Macikop/Solaris/electronics/3d views/mppt1.jpg

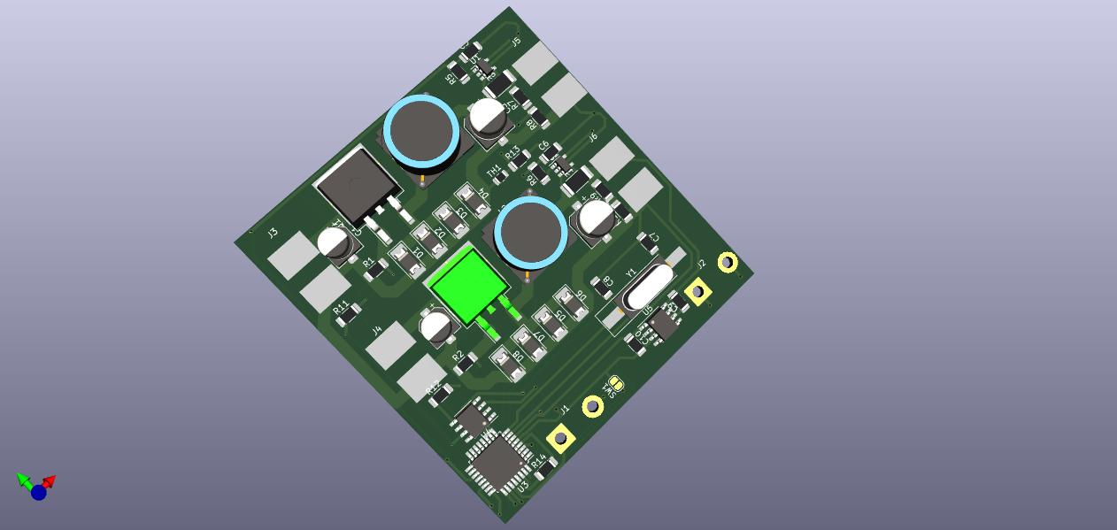
electronics/3d views/mppt1.jpg
