Macikop/Solaris/electronics/3d views/power_board.jpg

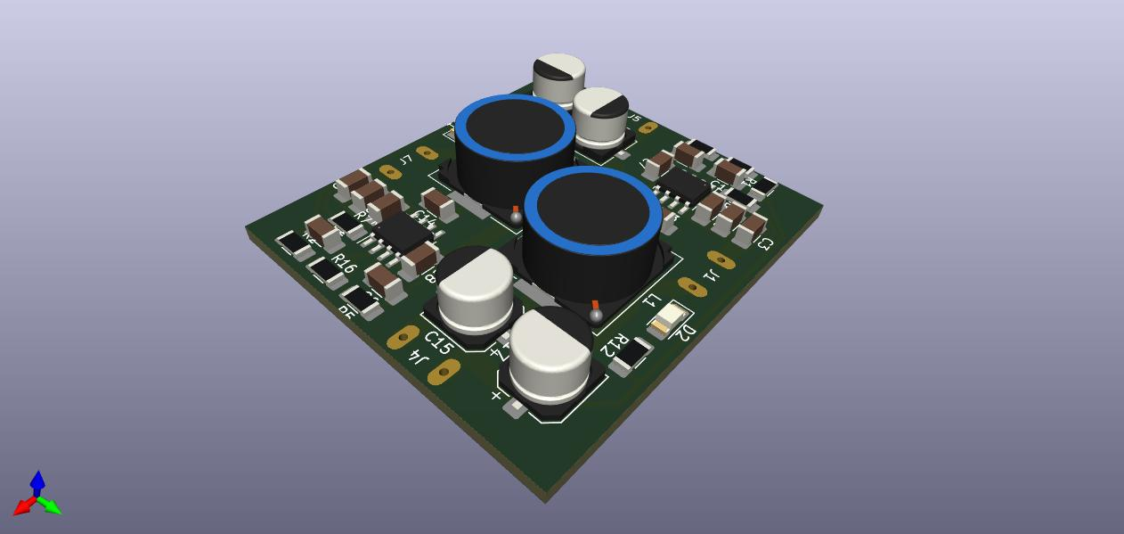
electronics/3d views/power_board.jpg
