Macikop/Solaris/electronics/3d views/autopilot.jpg

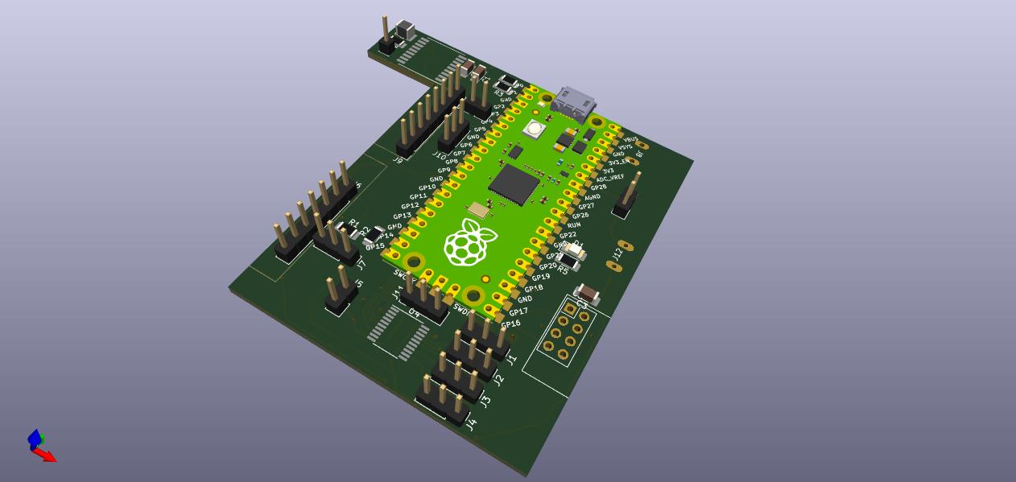
electronics/3d views/autopilot.jpg
