Macikop/Solaris/electronics/3d views/mppt.jpg

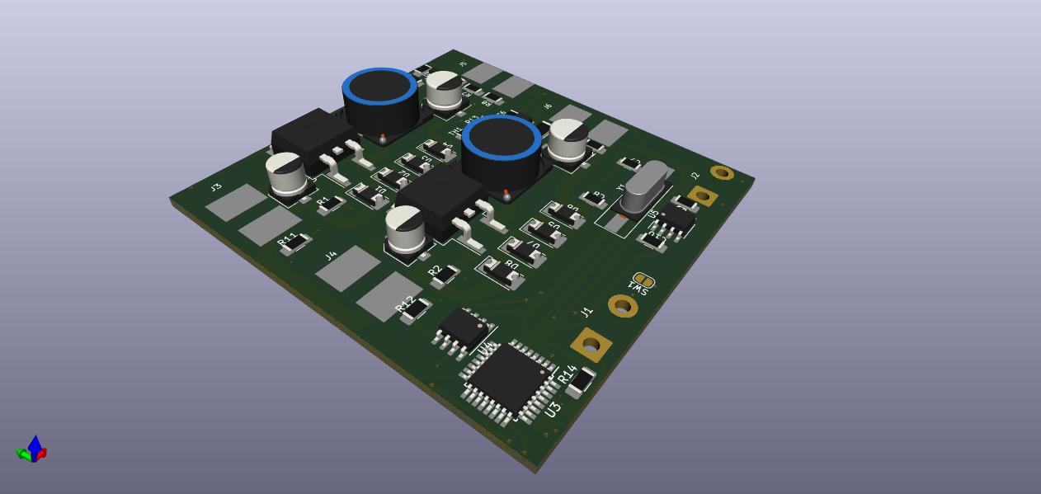
electronics/3d views/mppt.jpg
