Macikop/Solaris/electronics/3d views/power_board1.jpg

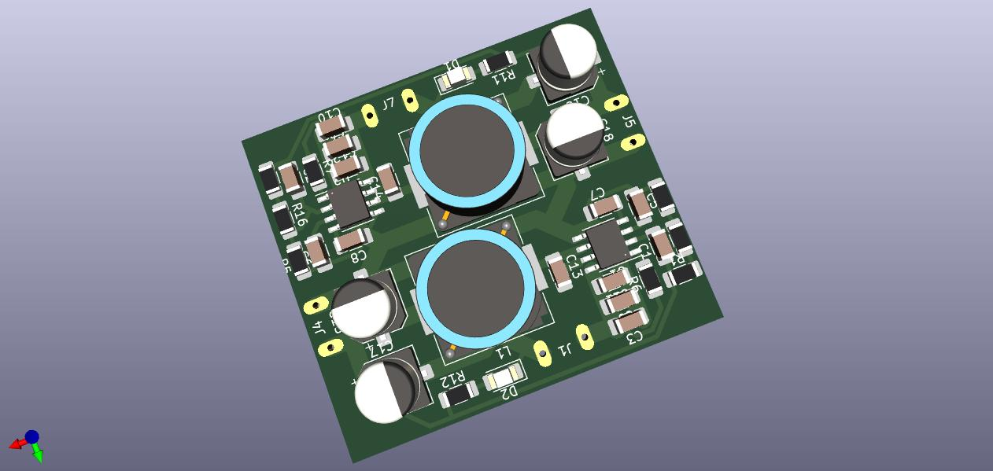
electronics/3d views/power_board1.jpg
