Macikop/Solaris/new model/Renders/Ino.png

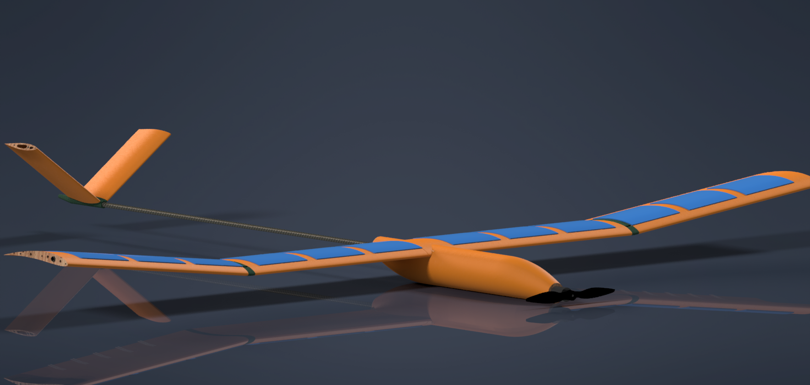
new model/Renders/Ino.png
