Macikop/Solaris/new model/Renders/Izo.png

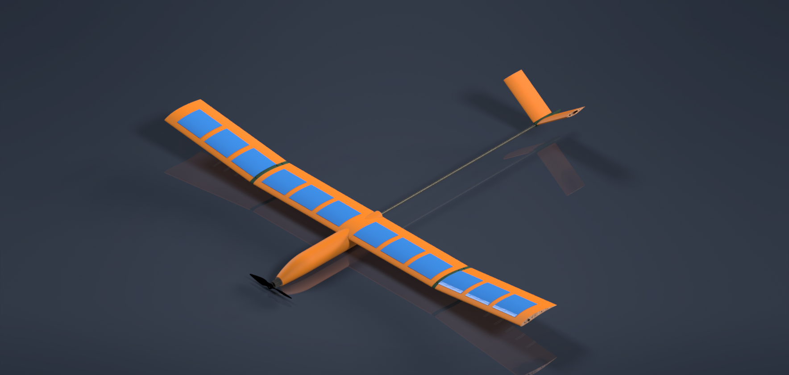
new model/Renders/Izo.png
