Macikop/Solaris/new model/Renders/Up.png

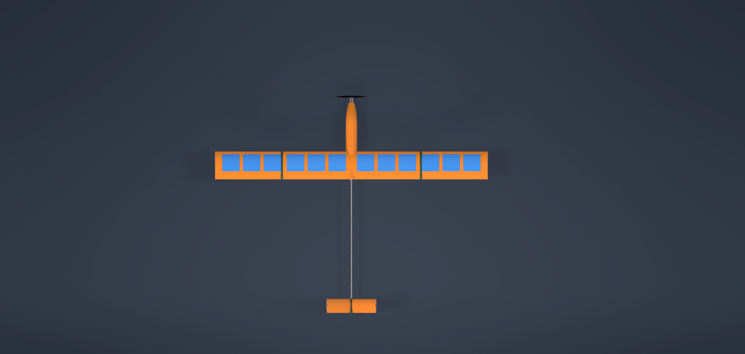
new model/Renders/Up.png
