Macikop/Solaris/new model/Renders/zic.png

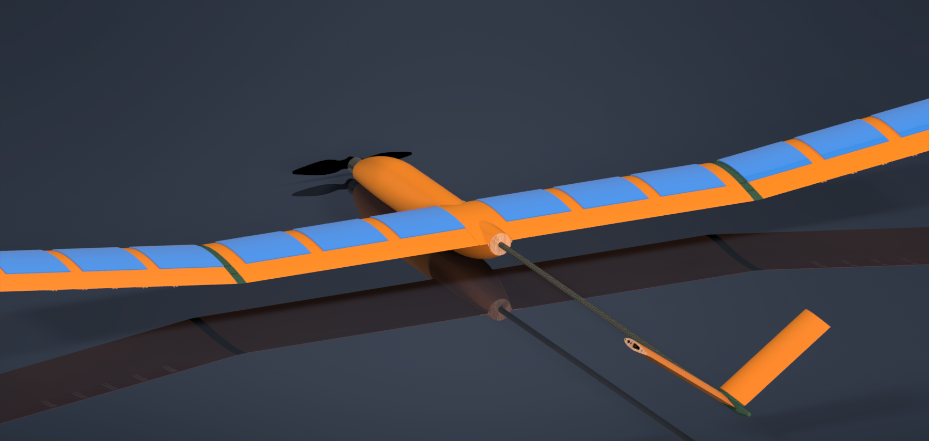
new model/Renders/zic.png
