Macikop/Solaris/new model/APC_9x6.SLDPRT

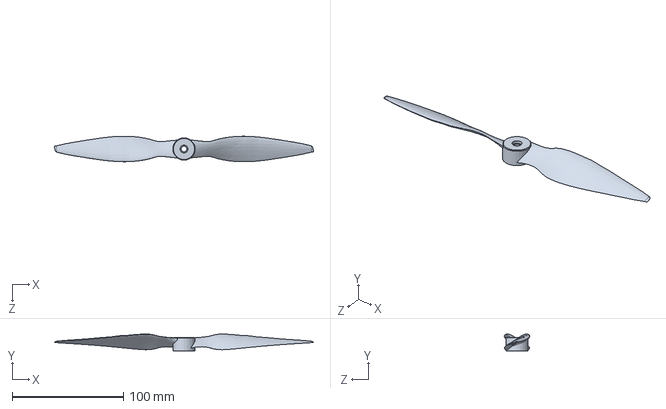
[picture p10: CAD file, 2023-02-10]
new model/APC_9x6.SLDPRT
232.6 x 15.2 x 22.9 mm
