Macikop/Solaris/(list of files, cad)

Other CAD files:
new model/Tail/Tżebro sketch.dwg
new model/APC_9x6.ipt
new model/Frez/Dlugie party(32-47)/OldVersions/Solid33.0001.ipt
new model/Frez/Dlugie party(32-47)/OldVersions/Solid35.0001.ipt
new model/Frez/Dlugie party(32-47)/OldVersions/Solid36.0001.ipt
new model/Frez/Dlugie party(32-47)/OldVersions/Solid37.0001.ipt
new model/Frez/Dlugie party(32-47)/OldVersions/Solid39.0001.ipt
new model/Frez/Dlugie party(32-47)/OldVersions/Solid40.0001.ipt
new model/Frez/Dlugie party(32-47)/OldVersions/Solid41.0001.ipt
new model/Frez/Dlugie party(32-47)/OldVersions/Solid42.0002.ipt
new model/Frez/Dlugie party(32-47)/OldVersions/Solid43.0002.ipt
new model/Frez/Dlugie party(32-47)/OldVersions/Solid44.0001.ipt
new model/Frez/Dlugie party(32-47)/OldVersions/Solid45.0001.ipt
new model/Frez/Dlugie party(32-47)/OldVersions/Solid46.0002.ipt
new model/Frez/Dlugie party(32-47)/OldVersions/Solid47.0002.ipt
new model/Frez/Dlugie party(32-47)/Solid32.ipt
new model/Frez/Dlugie party(32-47)/Solid33.ipt
new model/Frez/Dlugie party(32-47)/Solid34.ipt
new model/Frez/Dlugie party(32-47)/Solid35.ipt
new model/Frez/Dlugie party(32-47)/Solid36.ipt
new model/Frez/Dlugie party(32-47)/Solid37.ipt
new model/Frez/Dlugie party(32-47)/Solid38.ipt
new model/Frez/Dlugie party(32-47)/Solid39.ipt
new model/Frez/Dlugie party(32-47)/Solid40.ipt
new model/Frez/Dlugie party(32-47)/Solid41.ipt
new model/Frez/Dlugie party(32-47)/Solid42.ipt
new model/Frez/Dlugie party(32-47)/Solid43.ipt
new model/Frez/Dlugie party(32-47)/Solid44.ipt
new model/Frez/Dlugie party(32-47)/Solid45.ipt
new model/Frez/Dlugie party(32-47)/Solid46.ipt
new model/Frez/Dlugie party(32-47)/Solid47.ipt
new model/Frez/Frezowanie No.1.iam
new model/Frez/Frezowanie No.2.iam
new model/Frez/Frezowanie_male No.1.iam
new model/Frez/Frezowanie_male No.2.iam
new model/Frez/Frezowanie_male No.3.iam
new model/Frez/Kuplungi(48-65)/Solid48.ipt
new model/Frez/Kuplungi(48-65)/Solid49.ipt
new model/Frez/Kuplungi(48-65)/Solid50.ipt
new model/Frez/Kuplungi(48-65)/Solid51.ipt
new model/Frez/Kuplungi(48-65)/Solid52.ipt
new model/Frez/Kuplungi(48-65)/Solid53.ipt
new model/Frez/Kuplungi(48-65)/Solid54.ipt
new model/Frez/Kuplungi(48-65)/Solid55.ipt
new model/Frez/Kuplungi(48-65)/Solid56.ipt
new model/Frez/Kuplungi(48-65)/Solid57.ipt
new model/Frez/Kuplungi(48-65)/Solid60.ipt
new model/Frez/Kuplungi(48-65)/Solid61.ipt
new model/Frez/Kuplungi(48-65)/Solid62.ipt
new model/Frez/Kuplungi(48-65)/Solid63.ipt
new model/Frez/Kuplungi(48-65)/Solid64.ipt
new model/Frez/Kuplungi(48-65)/Solid65.ipt
new model/Frez/Laminat235x235.ipt
new model/Frez/Laminat297x210.ipt
new model/Frez/OldVersions/Frezowanie No.1.0007.iam
new model/Frez/OldVersions/Frezowanie No.2.0005.iam
new model/Frez/OldVersions/Frezowanie_male No.1.0004.iam
new model/Frez/OldVersions/Frezowanie_male No.2.0003.iam
new model/Frez/OldVersions/Frezowanie_male No.3.0003.iam
new model/Frez/Troche Mniejsze(2-31)/OldVersions/Solid2.0001.ipt
new model/Frez/Troche Mniejsze(2-31)/OldVersions/Solid28.0002.ipt
new model/Frez/Troche Mniejsze(2-31)/OldVersions/Solid29.0002.ipt
new model/Frez/Troche Mniejsze(2-31)/OldVersions/Solid30.0002.ipt
new model/Frez/Troche Mniejsze(2-31)/OldVersions/Solid31.0002.ipt
new model/Frez/Troche Mniejsze(2-31)/Solid10.ipt
new model/Frez/Troche Mniejsze(2-31)/Solid11.ipt
new model/Frez/Troche Mniejsze(2-31)/Solid12.ipt
new model/Frez/Troche Mniejsze(2-31)/Solid13.ipt
new model/Frez/Troche Mniejsze(2-31)/Solid14.ipt
new model/Frez/Troche Mniejsze(2-31)/Solid15.ipt
new model/Frez/Troche Mniejsze(2-31)/Solid16.ipt
new model/Frez/Troche Mniejsze(2-31)/Solid17.ipt
new model/Frez/Troche Mniejsze(2-31)/Solid18.ipt
new model/Frez/Troche Mniejsze(2-31)/Solid2.ipt
new model/Frez/Troche Mniejsze(2-31)/Solid28.ipt
new model/Frez/Troche Mniejsze(2-31)/Solid29.ipt
new model/Frez/Troche Mniejsze(2-31)/Solid3.ipt
new model/Frez/Troche Mniejsze(2-31)/Solid30.ipt
new model/Frez/Troche Mniejsze(2-31)/Solid31.ipt
new model/Frez/Troche Mniejsze(2-31)/Solid4.ipt
new model/Frez/Troche Mniejsze(2-31)/Solid5.ipt
new model/Frez/Troche Mniejsze(2-31)/Solid6.ipt
new model/Frez/Troche Mniejsze(2-31)/Solid7.ipt
new model/Frez/Troche Mniejsze(2-31)/Solid8.ipt
new model/Frez/Troche Mniejsze(2-31)/Solid9.ipt
new model/Frez_zebra/Balsa(95x1000x3).ipt
new model/Frez_zebra/Frez No,1.iam
new model/Frez_zebra/Frez No,2.iam
new model/Frez_zebra/Frez No,3.iam
new model/Frez_zebra/OldVersions/Balsa(95x1000x1.5).0003.ipt
new model/Frez_zebra/OldVersions/Frez No,1.0003.iam
new model/Frez_zebra/OldVersions/Frez No,2.0001.iam
new model/Jig/Back_back_aligner.ipt
new model/Jig/Back_front_aligner.ipt
new model/Jig/Front_aligner.ipt
new model/Jig/Jig_1.ipt
new model/Jig/Jig_2.ipt
new model/Jig/Jig_assembly.iam
new model/Jig/OldVersions/Back_front_aligner.0001.ipt
new model/Jig/OldVersions/Front_aligner.0003.ipt
new model/Jig/OldVersions/Jig_1.0010.ipt
new model/Jig/OldVersions/Jig_2.0006.ipt
new model/Jig/OldVersions/Jig_assembly.0012.iam
new model/Jig/Slider.ipt
new model/Jig/Widełki.ipt
new model/Lotka.ipt
new model/OldVersions/Lotka.0004.ipt
new model/OldVersions/Panele.0004.ipt
new model/OldVersions/Part17.0001.ipt
new model/OldVersions/Part19.0001.ipt
new model/OldVersions/Poszycie skrzydlo glowne.0001.ipt
new model/OldVersions/Poszycie skrzydlo sterowe.0003.ipt
new model/OldVersions/Poszycie.0005.ipt
new model/OldVersions/Powietrze.0001.ipt
new model/OldVersions/Samolot.0037.iam
new model/OldVersions/Skrzydło.0023.iam
new model/OldVersions/Tmount.0001.ipt
new model/OldVersions/Tżebro sketch.0001.ipt
new model/OldVersions/Wingspar trochemniejnizpol metrowy.0002.ipt
new model/OldVersions/battery.0001.ipt
new model/OldVersions/cienki_spar_dlugi.0003.ipt
new model/OldVersions/cienki_spar_krotki__ale_troche_dluzszy.0001.ipt
new model/OldVersions/kadlub_assembly.0003.iam
new model/OldVersions/kadłub.0011.ipt
new model/OldVersions/kuplung.0006.ipt
new model/OldVersions/mew.0001.iam
new model/OldVersions/skrzydlo_ster.0006.iam
new model/OldVersions/wingspar.0002.ipt
new model/OldVersions/Żebro default.0002.ipt
new model/OldVersions/Żebro sketch.0001.ipt
new model/OldVersions/Żebro z lotką.0002.ipt
new model/OldVersions/Żerbo montaż.0002.ipt
new model/Panele.ipt
new model/Poszycie skrzydlo glowne.ipt
new model/Poszycie skrzydlo sterowe.ipt
new model/Poszycie.ipt
new model/Prezentacje/OldVersions/Samolot.0001.ipn
new model/Prezentacje/Samolot.ipn
new model/Samolot bez sparow.iam
new model/Samolot.iam
new model/Silnik.ipt
new model/Skrzydlo_ster_mir/Lotka_MIR.ipt
new model/Skrzydlo_ster_mir/Wingspar trochemniejnizpol metrowy_MIR.ipt
new model/Skrzydlo_ster_mir/Zebro_lotka_MIR.iam
new model/Skrzydlo_ster_mir/skrzydlo_ster_MIR.iam
new model/Skrzydlo_ster_mir/Żebro default_MIR.ipt
new model/Skrzydlo_ster_mir/Żebro z lotką_MIR.ipt
new model/Skrzydlo_ster_mir/Żerbo montaż_MIR.ipt
new model/Skrzydło.iam
new model/Tail/OldVersions/Tail Poszycie.0002.ipt
new model/Tail/OldVersions/Tail.0010.iam
new model/Tail/OldVersions/Tmouint-edito.0007.ipt
new model/Tail/OldVersions/Tmount.0004.ipt
new model/Tail/OldVersions/TsmallSpar.0001.ipt
new model/Tail/OldVersions/Twingspar.0001.ipt
new model/Tail/Tail Poszycie.ipt
new model/Tail/Tail.iam
new model/Tail/Tlotka.ipt
new model/Tail/Tmouint-edito.ipt
new model/Tail/Tmount.ipt
new model/Tail/TsmallSpar.ipt
new model/Tail/Twingspar.ipt
new model/Tail/Tżebro default.ipt
new model/Tail/Tżebro sketch.ipt
new model/Tail/Tżebro z lotkąt.ipt
new model/Tail/Zebro_z_lotka.iam
new model/Wingspar trochemniejnizpol metrowy.ipt
new model/Zebro_lotka.iam
new model/battery.ipt
new model/cienki_spar_dlugi.ipt
new model/cienki_spar_krotki__ale_troche_dluzszy.ipt
new model/devices/ESC.ipt
new model/devices/OldVersions/Radio.0003.ipt
new model/devices/Radio.ipt
new model/kadłub.ipt
new model/kuplung.ipt
new model/motor.ipt
new model/nowy kadłub.ipt
new model/skrzydlo_ster.iam
new model/wingspar.ipt
new model/Żebro default.ipt
new model/Żebro sketch.ipt
new model/Żebro z lotką.ipt
new model/Żerbo montaż.ipt
