Macikop/Solaris/electronics/autopilot/autopilot.pdf

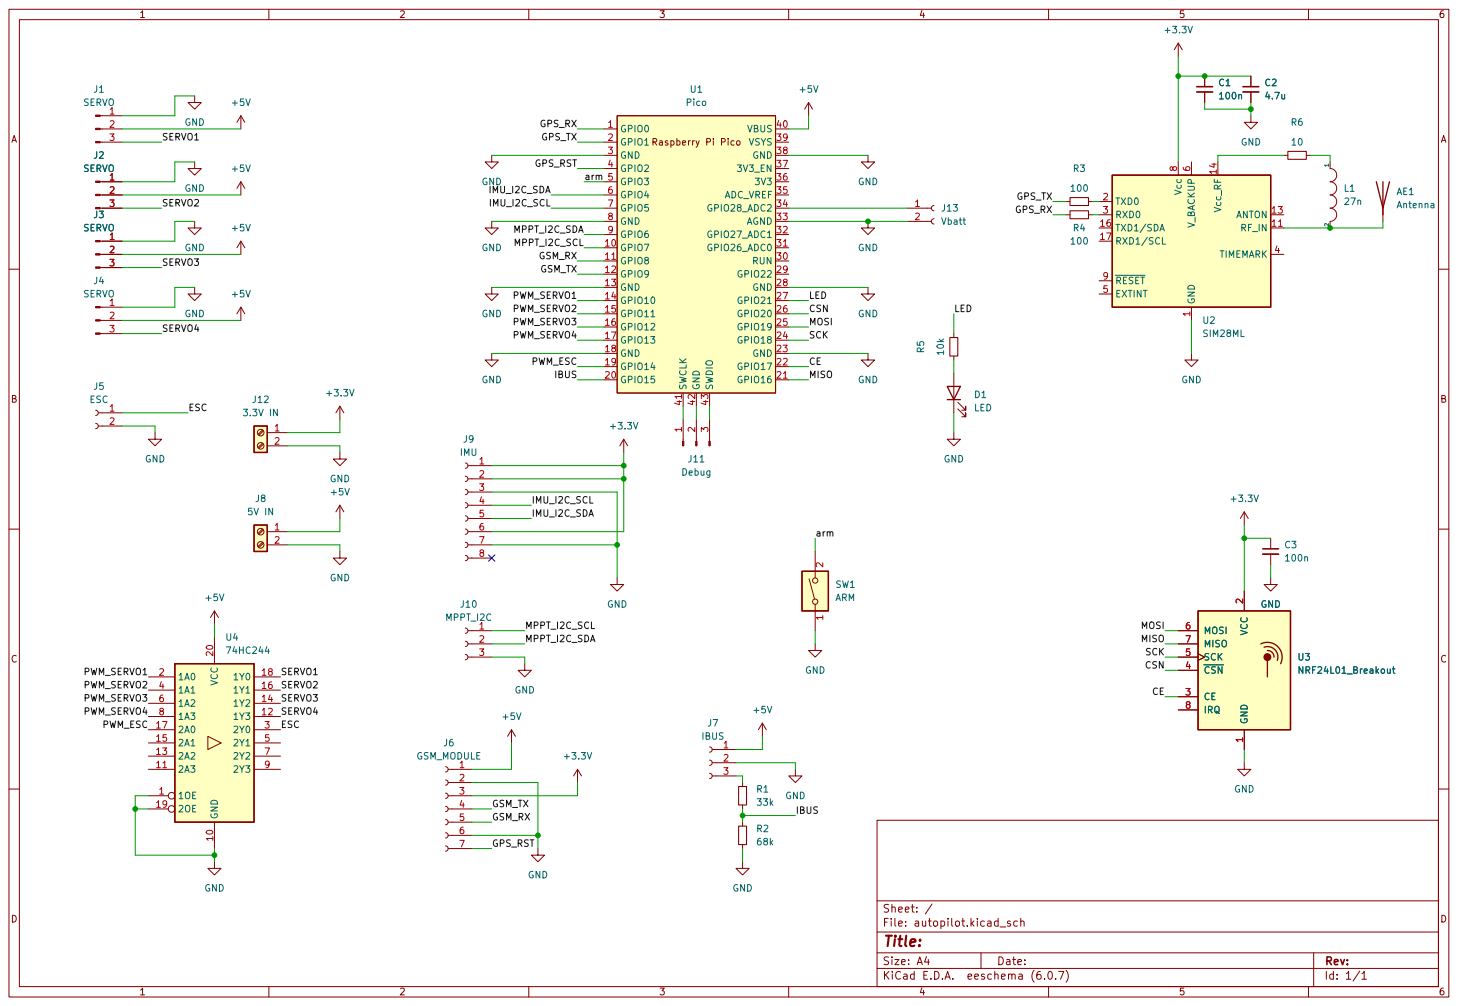
[picture p11: page 1]

GPS_RST GSM_RX GSM_TX GPS_RX GPS_TX
IMU GND GND GND GND

1 RF_IN 11 ANTON Vcc_RF 13 14 TXD1/SDA 16 RXD1/SCL 17 TXD0 2 RXD0 3 TIMEMARK 4 EXTINT 5 V_BACKUP

2 CE 3 ~{CSN} 4 SCK 5 MOSI 6 MISO 7
