Macikop/Solaris/new electronics/mppt/mppt/mppt.kicad_pcb

## KiCad design new electronics/mppt/mppt/mppt.kicad_pcb (2023-10-06)

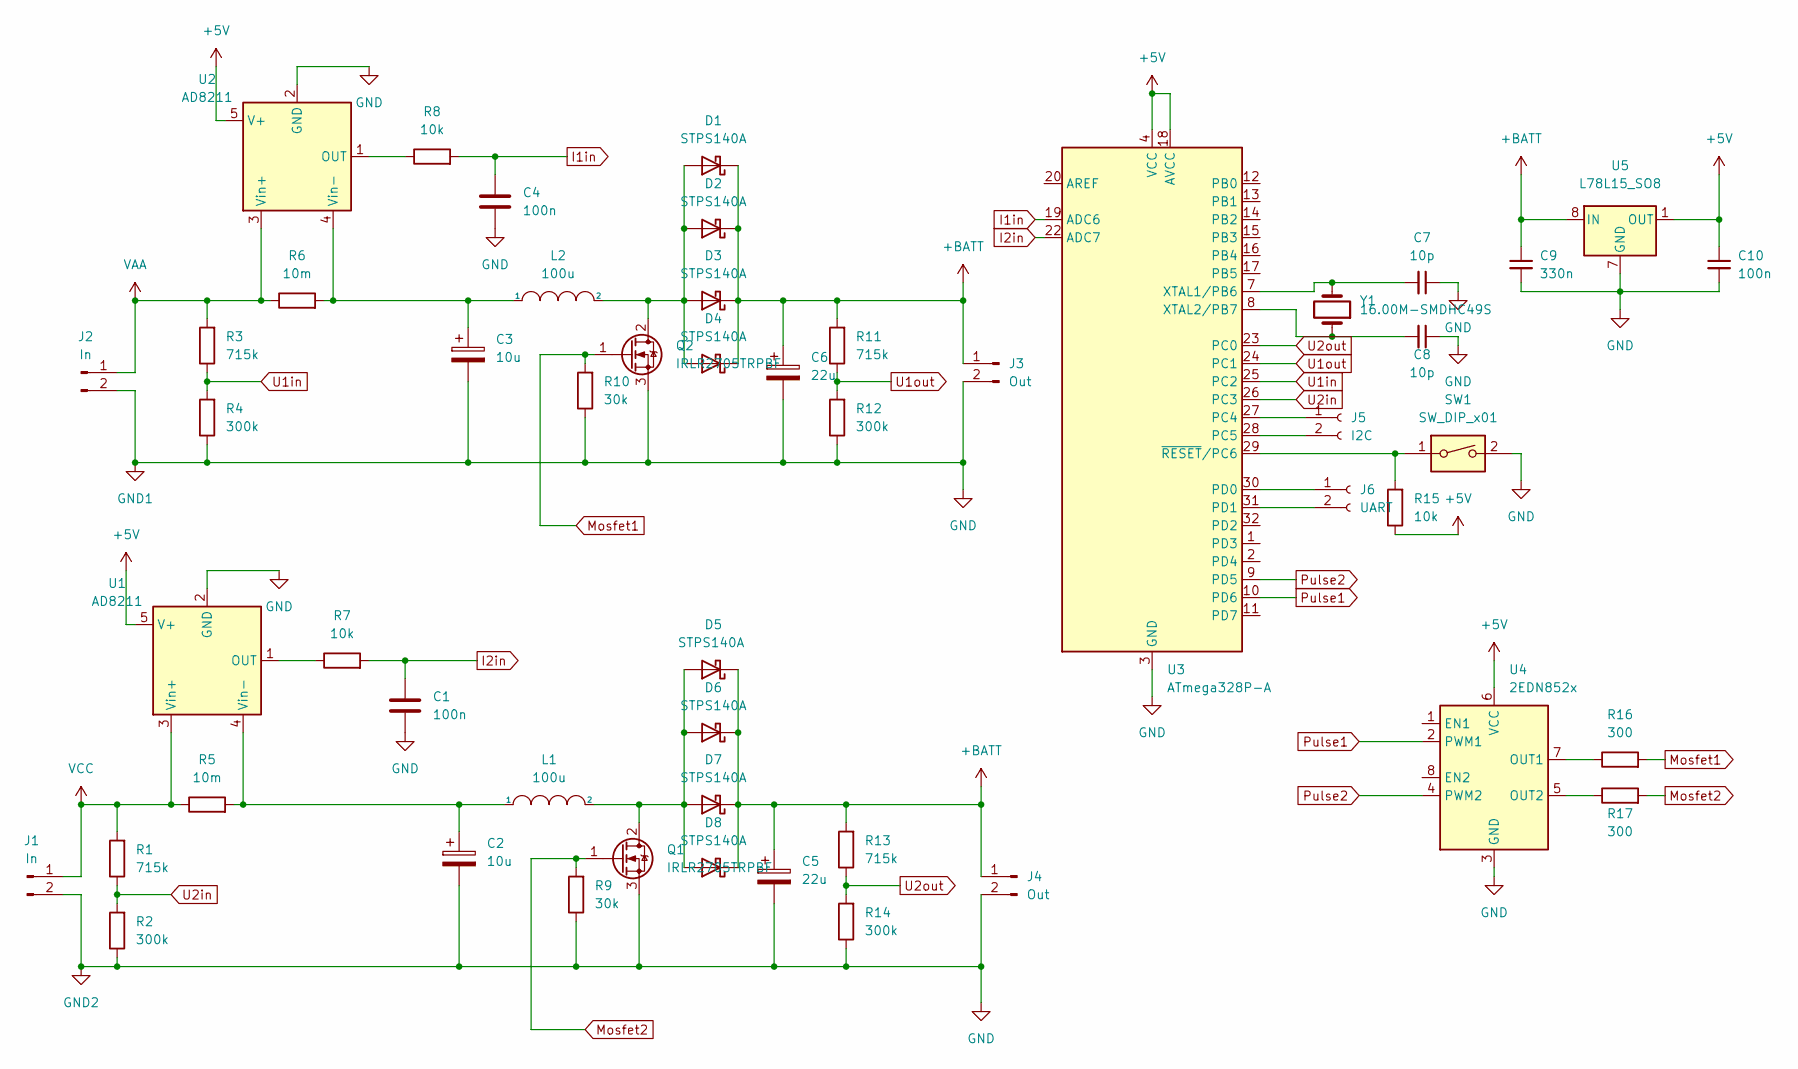
[picture p12: schematic mppt.kicad_sch]

Parts:
C1, C4, C10: 100n; R_1206_3216Metric_Pad1.30x1.75mm_HandSolder
C2, C3: 10u; CP_EIA-7343-15_Kemet-W_Pad2.25x2.55mm_HandSolder
C5, C6: 22u; CP_EIA-7343-15_Kemet-W_Pad2.25x2.55mm_HandSolder
C7, C8: 10p; R_1206_3216Metric_Pad1.30x1.75mm_HandSolder
C9: 330n; R_1206_3216Metric_Pad1.30x1.75mm_HandSolder
D1, D2, D3, D4, D5, D6, D7, D8: STPS140A; D_2010_5025Metric_Pad1.52x2.65mm_HandSolder
J1, J2: In; PowerPad
J3, J4: Out; PowerPad
J5: I2C; SolderWire-1.5sqmm_1x02_P7.8mm_D1.7mm_OD3.9mm
J6: UART; SolderWire-1.5sqmm_1x02_P7.8mm_D1.7mm_OD3.9mm
L1, L2: 100u; L_Bourns_SRR1208_12.7x12.7mm
Q1, Q2: IRLR2705TRPBF; TO-263-2
R1, R3, R11, R13: 715k; R_1206_3216Metric_Pad1.30x1.75mm_HandSolder
R2, R4, R12, R14: 300k; R_1206_3216Metric_Pad1.30x1.75mm_HandSolder
R5, R6: 10m; R_2010_5025Metric_Pad1.40x2.65mm_HandSolder
R7, R8, R15: 10k; R_1206_3216Metric_Pad1.30x1.75mm_HandSolder
R9, R10: 30k; R_1206_3216Metric_Pad1.30x1.75mm_HandSolder
R16, R17: 300; R_1206_3216Metric_Pad1.30x1.75mm_HandSolder
SW1: SW_DIP_x01; SolderJumper-2_P1.3mm_Open_RoundedPad1.0x1.5mm
U1, U2: AD8211; SOT-23-5
U3: ATmega328P-A; TQFP-32_7x7mm_P0.8mm
U4: 2EDN852x; SOIC-8_3.9x4.9mm_P1.27mm
U5: L78L15_SO8; SOIC-8_3.9x4.9mm_P1.27mm
Y1: 16.00M-SMDHC49S; Crystal_SMD_HC49-SD_HandSoldering

Connections:
+5V: C10.1, R15.1, U1.5 (V+), U2.5 (V+), U3.4 (VCC), U3.6 (VCC), U3.18 (AVCC), U4.6 (VCC), U5.1 (OUT)
+BATT: C5.1, C6.1, C9.1, D1.1 (K), D2.1 (K), D3.1 (K), D4.1 (K), D5.1 (K), D6.1 (K), D7.1 (K), D8.1 (K), J3.1, J4.1, R11.2, R13.2, U5.8 (IN)
GND: C1.2, C2.2, C3.2, C4.2, C5.2, C6.2, C7.1, C8.1, C9.2, C10.2, J1.2, J2.2, J3.2, J4.2, Q1.3 (S), Q2.3 (S), R2.1, R4.1, R9.1, R10.1, R12.1, R14.1, SW1.2, U1.2 (GND), U2.2 (GND), U3.3 (GND), U3.5 (GND), U3.21 (GND), U4.3 (GND), U5.2 (GND), U5.3 (GND), U5.6 (GND), U5.7 (GND)
I1in: C4.1, R8.2, U3.19 (ADC6)
I2in: C1.1, R7.2, U3.22 (ADC7)
Mosfet1: Q2.1 (G), R10.2, R16.2
Mosfet2: Q1.1 (G), R9.2, R17.2
unnamed: C2.1, L1.1, R5.2, U1.4 (Vin-)
unnamed: C3.1, L2.1, R6.2, U2.4 (Vin-)
unnamed: C7.2, U3.7 (XTAL1/PB6), Y1.2
unnamed: C8.2, U3.8 (XTAL2/PB7), Y1.1
unnamed: D1.2 (A), D2.2 (A), D3.2 (A), D4.2 (A), L2.2, Q2.2 (D)
unnamed: D5.2 (A), D6.2 (A), D7.2 (A), D8.2 (A), L1.2, Q1.2 (D)
unnamed: J5.1, U3.27 (PC4)
unnamed: J5.2, U3.28 (PC5)
unnamed: J6.1, U3.30 (PD0)
unnamed: J6.2, U3.31 (PD1)
unnamed: R7.1, U1.1 (OUT)
unnamed: R8.1, U2.1 (OUT)
unnamed: R15.2, SW1.1, U3.29 (~RESET/PC6)
unnamed: R16.1, U4.7 (OUT1)
unnamed: R17.1, U4.5 (OUT2)
Pulse1: U3.10 (PD6), U4.2 (PWM1)
Pulse2: U3.9 (PD5), U4.4 (PWM2)
U1in: R3.1, R4.2, U3.25 (PC2)
U1out: R11.1, R12.2, U3.24 (PC1)
U2in: R1.1, R2.2, U3.26 (PC3)
U2out: R13.1, R14.2, U3.23 (PC0)
VAA: J2.1, R3.2, R6.1, U2.3 (Vin+)
VCC: J1.1, R1.2, R5.1, U1.3 (Vin+)

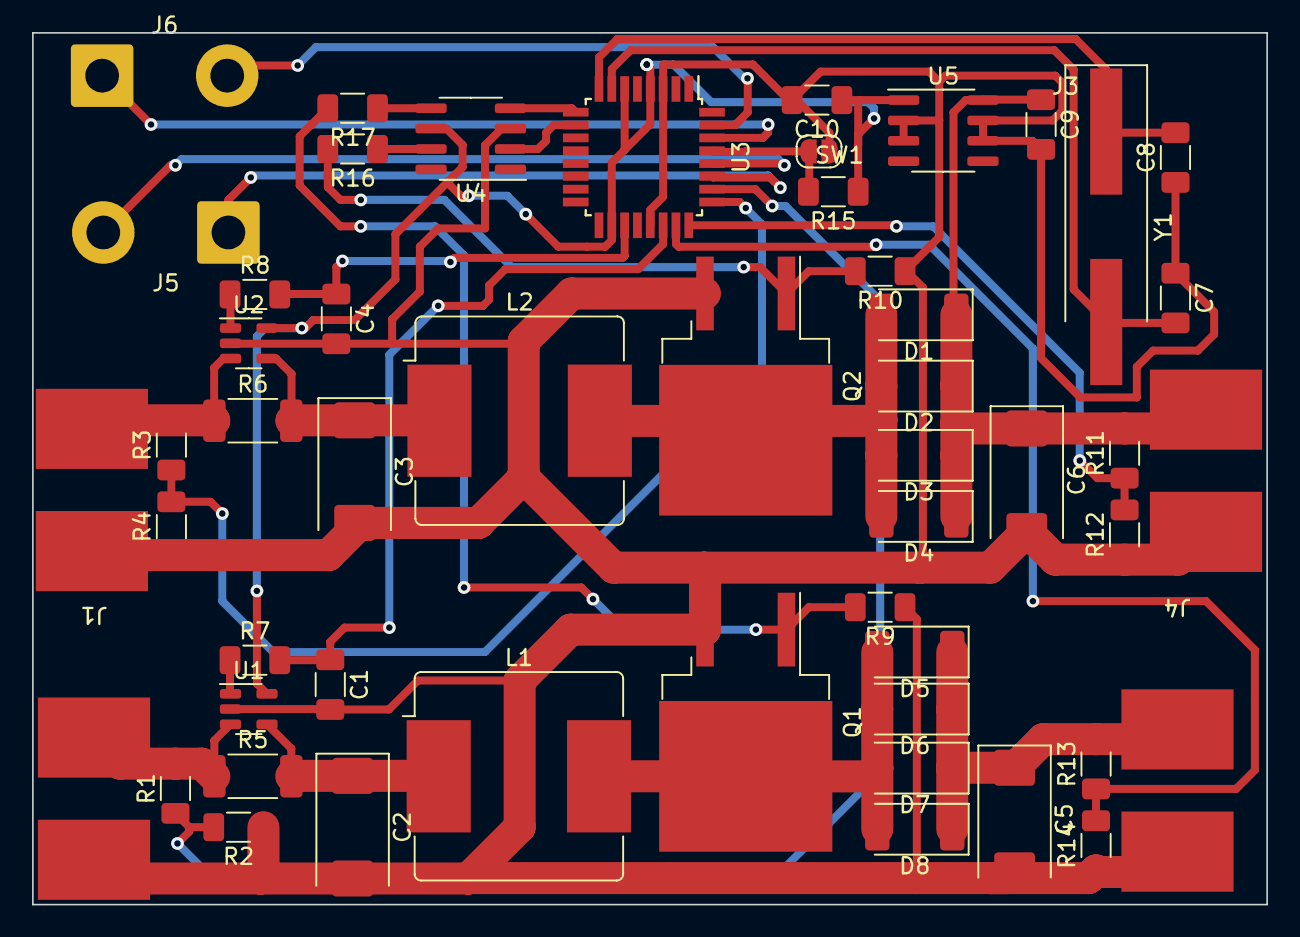
[picture p13: board new electronics/mppt/mppt/mppt.kicad_pcb from above]

Board: 2 copper layers, 77.0 x 54.4 mm, 52 parts (0 on the bottom side), 30 nets.
