Macikop/Solaris/electronics/autopilot/autopilot.kicad_pcb

## KiCad design electronics/autopilot/autopilot.kicad_pcb (2023-09-12, an earlier design)

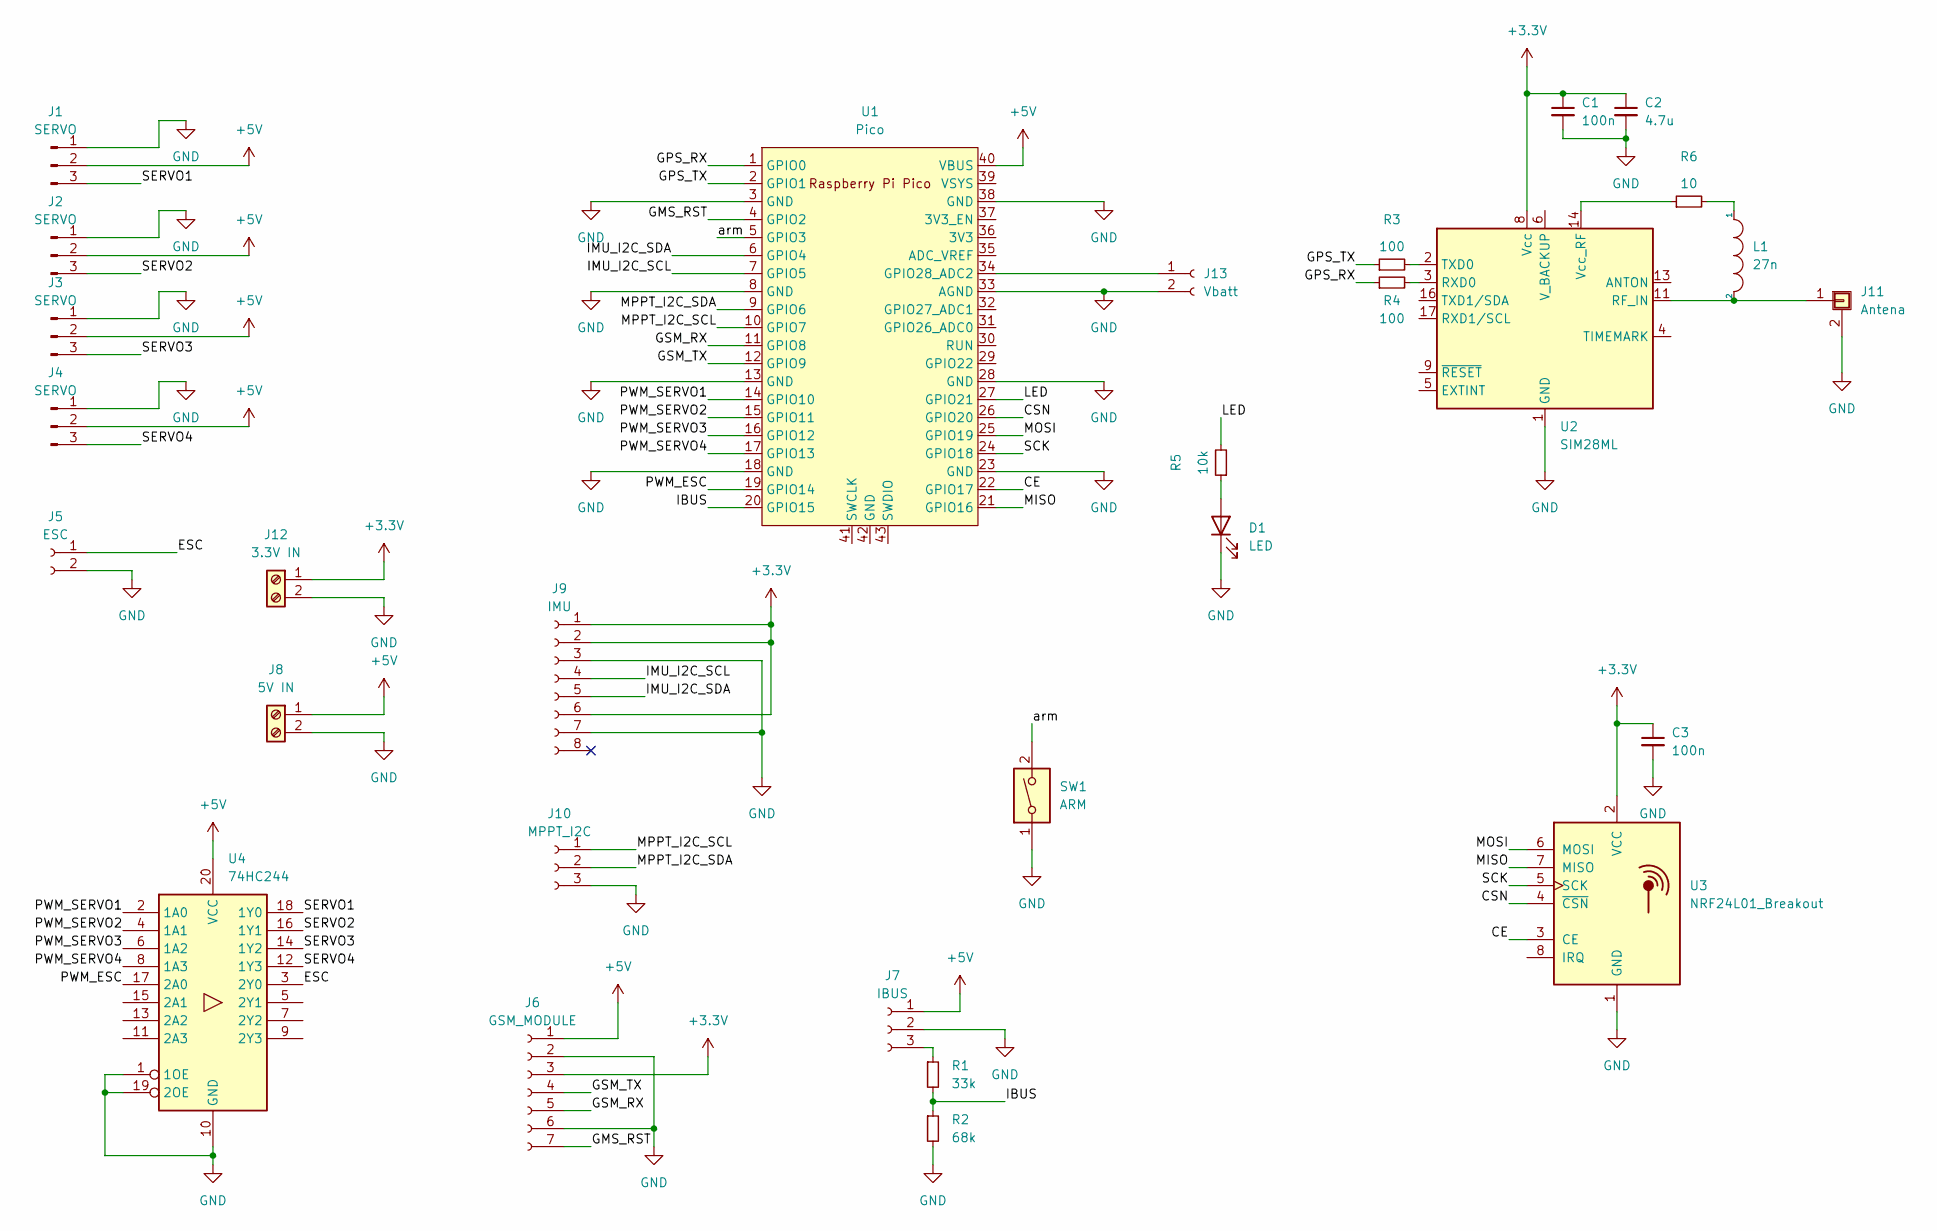
[picture p14: schematic autopilot.kicad_sch]

Parts:
C1, C3: 100n; C_1206_3216Metric_Pad1.33x1.80mm_HandSolder
C2: 4.7u; C_1206_3216Metric_Pad1.33x1.80mm_HandSolder
D1: LED; LED_1206_3216Metric_Pad1.42x1.75mm_HandSolder
J1, J2, J3, J4: SERVO; PinHeader_1x03_P2.54mm_Vertical
J5: ESC; PinHeader_1x02_P2.54mm_Vertical
J6: GSM_MODULE; PinHeader_1x07_P2.54mm_Vertical
J7: IBUS; PinHeader_1x03_P2.54mm_Vertical
J8: 5V IN; ARK
J9: IMU; PinHeader_1x08_P2.54mm_Vertical
J10: MPPT_I2C; PinHeader_1x03_P2.54mm_Vertical
J11: Antena; U.FL_Molex_MCRF_73412-0110_Vertical
J12: 3.3V IN; ARK
J13: Vbatt; PinHeader_1x02_P2.54mm_Vertical
L1: 27n; L_1210_3225Metric_Pad1.42x2.65mm_HandSolder
R1: 33k; R_1206_3216Metric_Pad1.30x1.75mm_HandSolder
R2: 68k; R_1206_3216Metric_Pad1.30x1.75mm_HandSolder
R3, R4: 100; R_1206_3216Metric_Pad1.30x1.75mm_HandSolder
R5: 10k; R_1206_3216Metric_Pad1.30x1.75mm_HandSolder
R6: 10; R_1206_3216Metric_Pad1.30x1.75mm_HandSolder
SW1: ARM; PinHeader_1x02_P2.54mm_Vertical
U1: Pico; RPi_Pico_SMD_TH
U2: SIM28ML
U3: NRF24L01_Breakout; nRF24L01_Breakout
U4: 74HC244; SO-20_12.8x7.5mm_P1.27mm

Connections:
+3.3V: C1.1, C2.1, C3.1, J6.3, J9.1, J9.2, J9.6, J12.1, U2.8 (Vcc), U3.2 (VCC)
+5V: J1.2, J2.2, J3.2, J4.2, J6.1, J7.1, J8.1, U1.40 (VBUS), U4.20 (VCC)
/CE: U1.22 (GPIO17), U3.3 (CE)
/CSN: U1.26 (GPIO20), U3.4 (~CSN)
/ESC: J5.1, U4.3 (2Y0)
/GMS_RST: J6.7, U1.4 (GPIO2)
/GPS_RX: R4.1, U1.1 (GPIO0)
/GPS_TX: R3.1, U1.2 (GPIO1)
/GSM_RX: J6.5, U1.11 (GPIO8)
/GSM_TX: J6.4, U1.12 (GPIO9)
/IBUS: R1.2, R2.1, U1.20 (GPIO15)
/IMU_I2C_SCL: J9.4, U1.7 (GPIO5)
/IMU_I2C_SDA: J9.5, U1.6 (GPIO4)
/LED: R5.2, U1.27 (GPIO21)
/MISO: U1.21 (GPIO16), U3.7 (MISO)
/MOSI: U1.25 (GPIO19), U3.6 (MOSI)
/MPPT_I2C_SCL: J10.1, U1.10 (GPIO7)
/MPPT_I2C_SDA: J10.2, U1.9 (GPIO6)
/PWM_ESC: U1.19 (GPIO14), U4.17 (2A0)
/PWM_SERVO1: U1.14 (GPIO10), U4.2 (1A0)
/PWM_SERVO2: U1.15 (GPIO11), U4.4 (1A1)
/PWM_SERVO3: U1.16 (GPIO12), U4.6 (1A2)
/PWM_SERVO4: U1.17 (GPIO13), U4.8 (1A3)
/SCK: U1.24 (GPIO18), U3.5 (SCK)
/SERVO1: J1.3, U4.18 (1Y0)
/SERVO2: J2.3, U4.16 (1Y1)
/SERVO3: J3.3, U4.14 (1Y2)
/SERVO4: J4.3, U4.12 (1Y3)
/arm: SW1.2, U1.5 (GPIO3)
GND: C1.2, C2.2, C3.2, D1.1 (K), J1.1, J2.1, J3.1, J4.1, J5.2, J6.2, J6.6, J7.2, J8.2, J9.3, J9.7, J10.3, J11.2 (Shield), J12.2, J13.2, R2.2, SW1.1, U1.3 (GND), U1.8 (GND), U1.13 (GND), U1.18 (GND), U1.23 (GND), U1.28 (GND), U1.33 (AGND), U1.38 (GND), U2.1 (GND), U2.10 (GND), U2.12 (GND), U3.1 (GND), U4.1 (1OE), U4.10 (GND), U4.19 (2OE)
unnamed: D1.2 (A), R5.1
unnamed: J7.3, R1.1
unnamed: J13.1, U1.34 (GPIO28_ADC2)
unnamed: L1.1, R6.2
unnamed: J11.1, L1.2, U2.11 (RF_IN)
unnamed: R3.2, U2.2 (TXD0)
unnamed: R4.2, U2.3 (RXD0)
unnamed: R6.1, U2.14 (Vcc_RF)

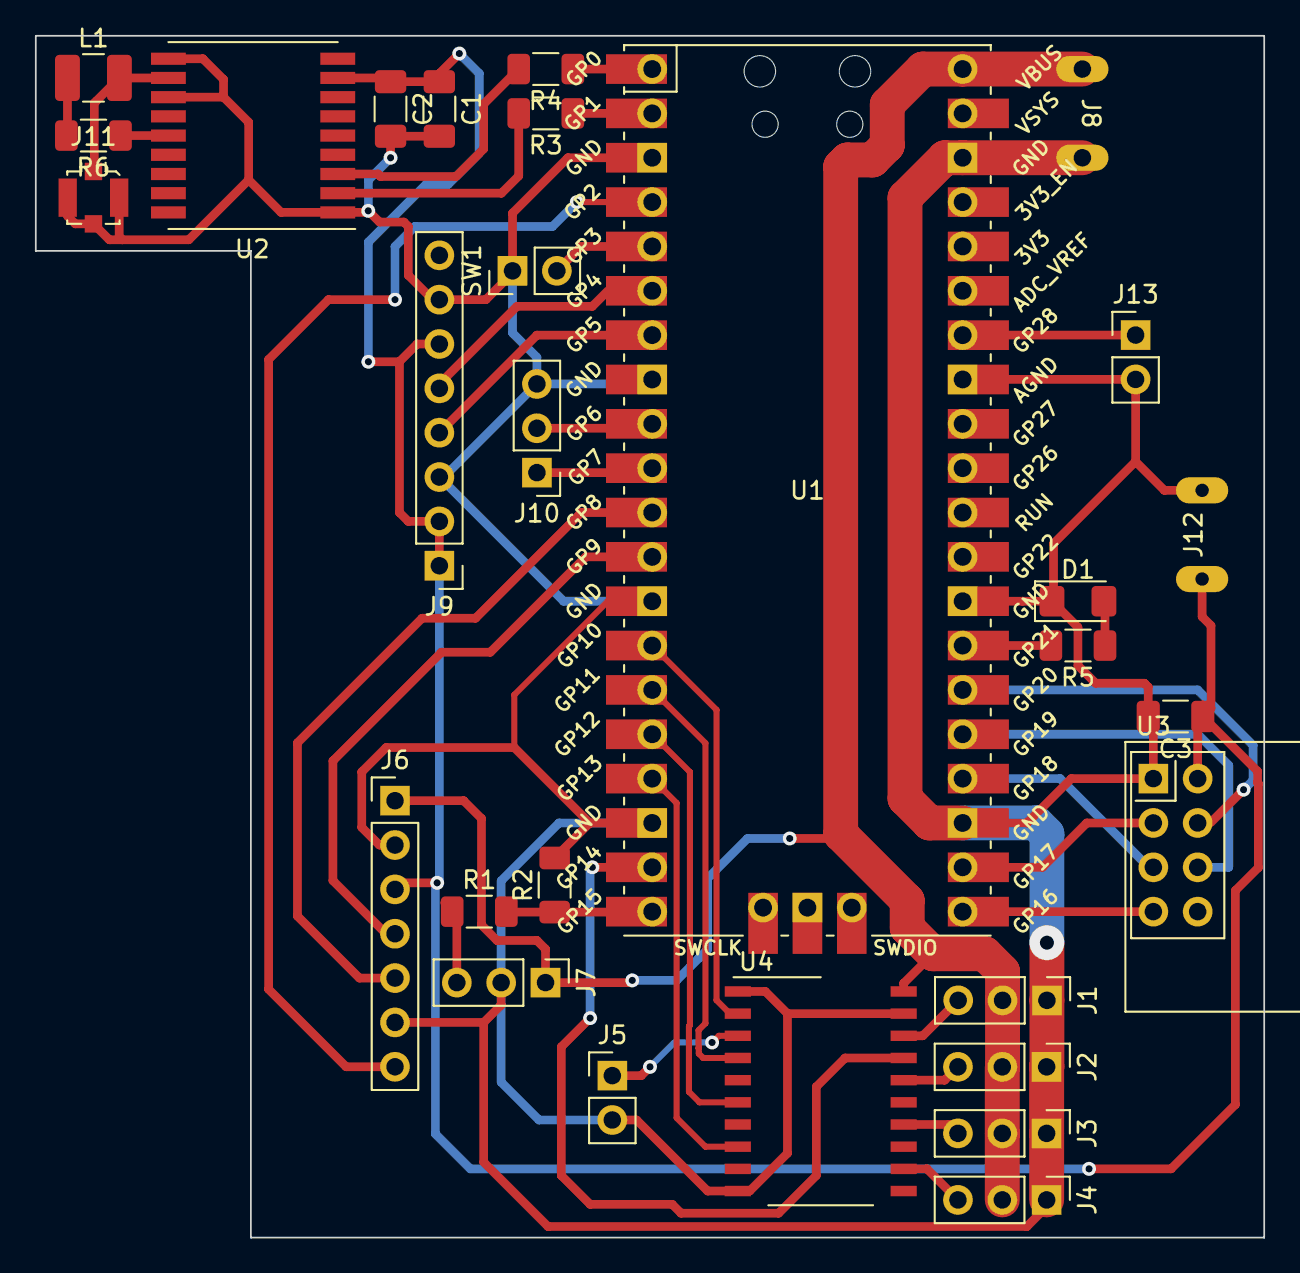
[picture p15: board autopilot.kicad_pcb from above]

Board: 2 copper layers, 70.4 x 68.8 mm, 29 parts (0 on the bottom side), 38 nets.
