Macikop/Solaris/electronics/power_board/power_board.kicad_pcb

## KiCad design electronics/power_board/power_board.kicad_pcb (2023-02-07)

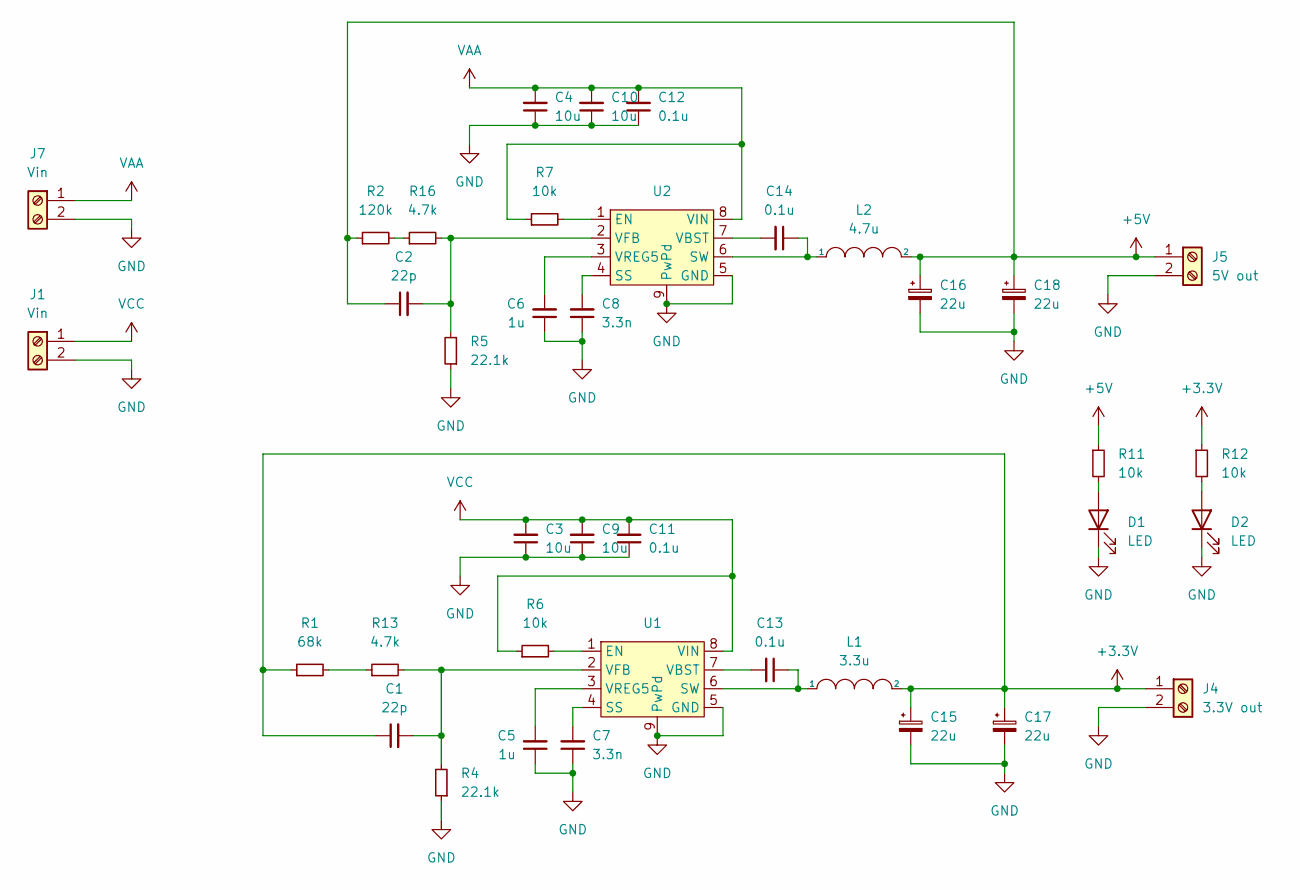
[picture p16: schematic power_board.kicad_sch]

Parts:
C1, C2: 22p; C_1206_3216Metric_Pad1.33x1.80mm_HandSolder
C3, C4, C9, C10: 10u; C_1206_3216Metric_Pad1.33x1.80mm_HandSolder
C5, C6: 1u; C_1206_3216Metric_Pad1.33x1.80mm_HandSolder
C7, C8: 3.3n; C_1206_3216Metric_Pad1.33x1.80mm_HandSolder
C11, C12, C13, C14: 0.1u; C_1206_3216Metric_Pad1.33x1.80mm_HandSolder
C15, C16, C17, C18: 22u; CP_Elec_6.3x5.4
D1, D2: LED; LED_1206_3216Metric_Pad1.42x1.75mm_HandSolder
J1, J7: Vin; ARK
J4: 3.3V out; ARK
J5: 5V out; ARK
L1: 3.3u; L_Neosid_SM-NE127_HandSoldering
L2: 4.7u; L_Neosid_SM-NE127_HandSoldering
R1: 68k; R_1206_3216Metric_Pad1.30x1.75mm_HandSolder
R2: 120k; R_1206_3216Metric_Pad1.30x1.75mm_HandSolder
R4, R5: 22.1k; R_1206_3216Metric_Pad1.30x1.75mm_HandSolder
R6, R7, R11, R12: 10k; R_1206_3216Metric_Pad1.30x1.75mm_HandSolder
R13, R16: 4.7k; R_1206_3216Metric_Pad1.30x1.75mm_HandSolder
U1, U2: TPS54228; HSOP-8-1EP_3.9x4.9mm_P1.27mm_EP2.41x3.1mm

Connections:
+3.3V: C1.1, C15.1, C17.1, J4.1, L1.2, R1.1, R12.1
+5V: C2.1, C16.1, C18.1, J5.1, L2.2, R2.1, R11.1
GND: C3.1, C4.1, C5.1, C6.1, C7.1, C8.1, C9.1, C10.1, C11.1, C12.1, C15.2, C16.2, C17.2, C18.2, D1.1 (K), D2.1 (K), J1.2, J4.2, J5.2, J7.2, R4.1, R5.1, U1.5 (GND), U1.9 (PwPd), U2.5 (GND), U2.9 (PwPd)
unnamed: C1.2, R4.2, R13.2, U1.2 (VFB)
unnamed: C2.2, R5.2, R16.2, U2.2 (VFB)
unnamed: C5.2, U1.3 (VREG5)
unnamed: C6.2, U2.3 (VREG5)
unnamed: C7.2, U1.4 (SS)
unnamed: C8.2, U2.4 (SS)
unnamed: C13.1, L1.1, U1.6 (SW)
unnamed: C13.2, U1.7 (VBST)
unnamed: C14.1, L2.1, U2.6 (SW)
unnamed: C14.2, U2.7 (VBST)
unnamed: D1.2 (A), R11.2
unnamed: D2.2 (A), R12.2
unnamed: R1.2, R13.1
unnamed: R2.2, R16.1
unnamed: R6.2, U1.1 (EN)
unnamed: R7.2, U2.1 (EN)
VAA: C4.2, C10.2, C12.2, J7.1, R7.1, U2.8 (VIN)
VCC: C3.2, C9.2, C11.2, J1.1, R6.1, U1.8 (VIN)

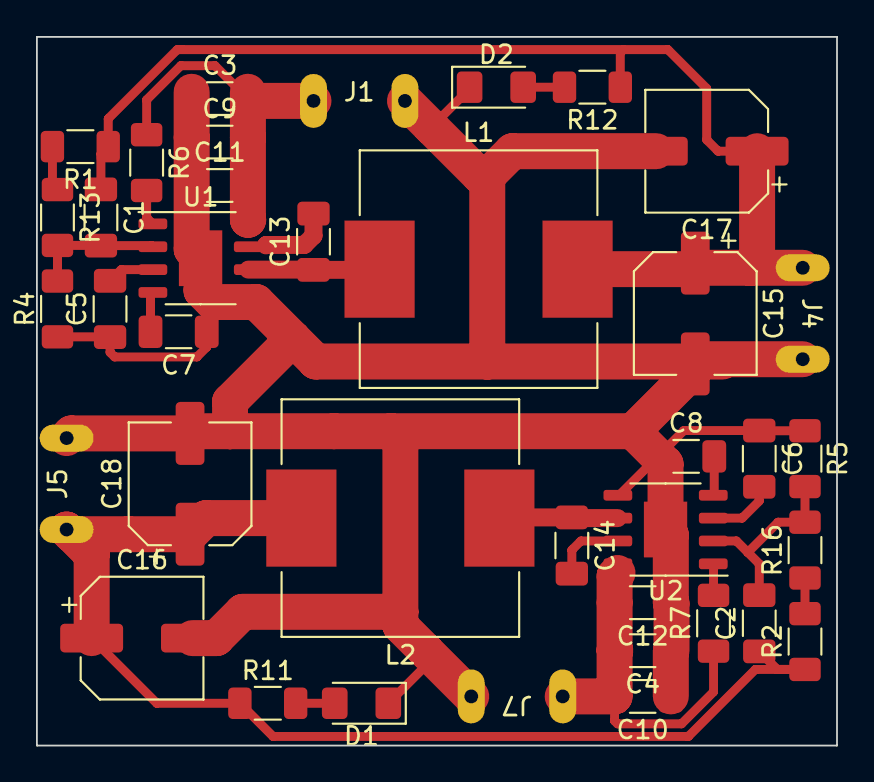
[picture p17: board power_board.kicad_pcb from above]

Board: 2 copper layers, 44.5 x 39.4 mm, 38 parts (0 on the bottom side), 21 nets.
