Macikop/Solaris/electronics/mppt_buck/mppt.kicad_pcb

## KiCad design electronics/mppt_buck/mppt.kicad_pcb (2023-02-07, an earlier design)

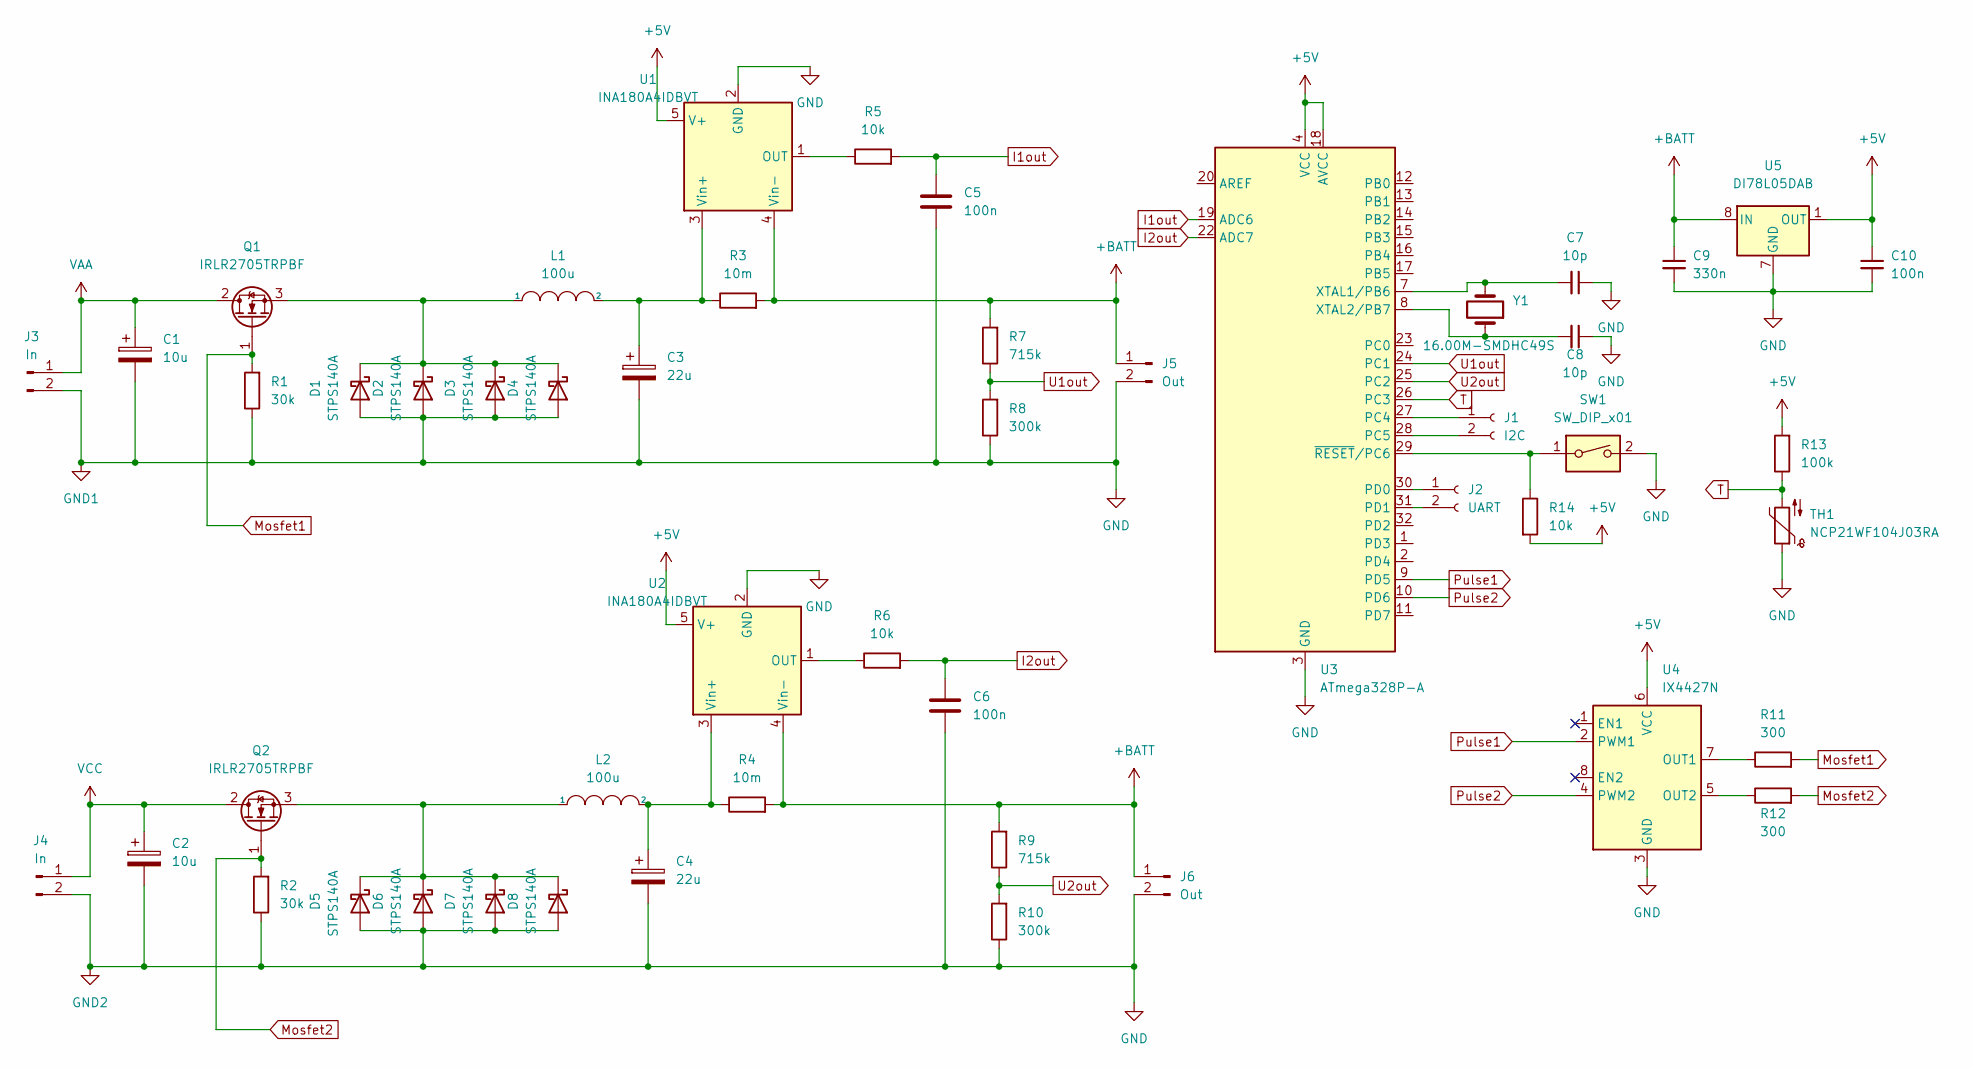
[picture p18: schematic mppt.kicad_sch]

Parts:
C1, C2: 10u; CP_Elec_5x5.4
C3, C4: 22u; CP_Elec_6.3x5.4
C5, C6, C10: 100n; R_1206_3216Metric_Pad1.30x1.75mm_HandSolder
C7, C8: 10p; R_1206_3216Metric_Pad1.30x1.75mm_HandSolder
C9: 330n; R_1206_3216Metric_Pad1.30x1.75mm_HandSolder
D1, D2, D3, D4, D5, D6, D7, D8: STPS140A; D_2010_5025Metric_Pad1.52x2.65mm_HandSolder
J1: I2C; SolderWire-1.5sqmm_1x02_P7.8mm_D1.7mm_OD3.9mm
J2: UART; SolderWire-1.5sqmm_1x02_P7.8mm_D1.7mm_OD3.9mm
J3, J4: In; PowerPad
J5, J6: Out; PowerPad
L1, L2: 100u; L_10.4x10.4_H4.8
Q1, Q2: IRLR2705TRPBF; TO-263-2
R1, R2: 30k; R_1206_3216Metric_Pad1.30x1.75mm_HandSolder
R3, R4: 10m; R_2010_5025Metric_Pad1.40x2.65mm_HandSolder
R5, R6, R14: 10k; R_1206_3216Metric_Pad1.30x1.75mm_HandSolder
R7, R9: 715k; R_1206_3216Metric_Pad1.30x1.75mm_HandSolder
R8, R10: 300k; R_1206_3216Metric_Pad1.30x1.75mm_HandSolder
R11, R12: 300; R_1206_3216Metric_Pad1.30x1.75mm_HandSolder
R13: 100k; R_1206_3216Metric_Pad1.30x1.75mm_HandSolder
SW1: SW_DIP_x01; SolderJumper-2_P1.3mm_Open_RoundedPad1.0x1.5mm
TH1: NCP21WF104J03RA; R_0805_2012Metric
U1, U2: INA180A4IDBVT; SOT-23-5
U3: ATmega328P-A; TQFP-32_7x7mm_P0.8mm
U4: IX4427N; SOIC-8_3.9x4.9mm_P1.27mm
U5: DI78L05DAB; SOIC-8_3.9x4.9mm_P1.27mm
Y1: 16.00M-SMDHC49S; Crystal_SMD_HC49-SD_HandSoldering

Connections:
+5V: C10.1, R13.2, R14.2, U1.5 (V+), U2.5 (V+), U3.4 (VCC), U3.6 (VCC), U3.18 (AVCC), U4.6 (VCC), U5.1 (OUT)
+BATT: C9.1, J5.1, J6.1, R3.2, R4.2, R7.2, R9.2, U1.4 (Vin-), U2.4 (Vin-), U5.8 (IN)
GND: C1.2, C2.2, C3.2, C4.2, C5.2, C6.2, C7.1, C8.1, C9.2, C10.2, D1.2 (A), D2.2 (A), D3.2 (A), D4.2 (A), D5.2 (A), D6.2 (A), D7.2 (A), D8.2 (A), J3.2, J4.2, J5.2, J6.2, R1.1, R2.1, R8.1, R10.1, SW1.2, TH1.1, U1.2 (GND), U2.2 (GND), U3.3 (GND), U3.5 (GND), U3.21 (GND), U4.3 (GND), U5.2 (GND), U5.3 (GND), U5.6 (GND), U5.7 (GND)
I1out: C5.1, R5.2, U3.19 (ADC6)
I2out: C6.1, R6.2, U3.22 (ADC7)
Mosfet1: Q1.1 (G), R1.2, R11.2
Mosfet2: Q2.1 (G), R2.2, R12.2
unnamed: C3.1, L1.2, R3.1, U1.3 (Vin+)
unnamed: C4.1, L2.2, R4.1, U2.3 (Vin+)
unnamed: C7.2, U3.7 (XTAL1/PB6), Y1.2
unnamed: C8.2, U3.8 (XTAL2/PB7), Y1.1
unnamed: D1.1 (K), D2.1 (K), D3.1 (K), D4.1 (K), L1.1, Q1.3 (S)
unnamed: D5.1 (K), D6.1 (K), D7.1 (K), D8.1 (K), L2.1, Q2.3 (S)
unnamed: J1.1, U3.27 (PC4)
unnamed: J1.2, U3.28 (PC5)
unnamed: J2.1, U3.30 (PD0)
unnamed: J2.2, U3.31 (PD1)
unnamed: R5.1, U1.1 (OUT)
unnamed: R6.1, U2.1 (OUT)
unnamed: R11.1, U4.7 (OUT1)
unnamed: R12.1, U4.5 (OUT2)
unnamed: R14.1, SW1.1, U3.29 (~RESET/PC6)
Pulse1: U3.9 (PD5), U4.2 (PWM1)
Pulse2: U3.10 (PD6), U4.4 (PWM2)
T: R13.1, TH1.2, U3.26 (PC3)
U1out: R7.1, R8.2, U3.24 (PC1)
U2out: R9.1, R10.2, U3.25 (PC2)
VAA: C1.1, J3.1, Q1.2 (D)
VCC: C2.1, J4.1, Q2.2 (D)

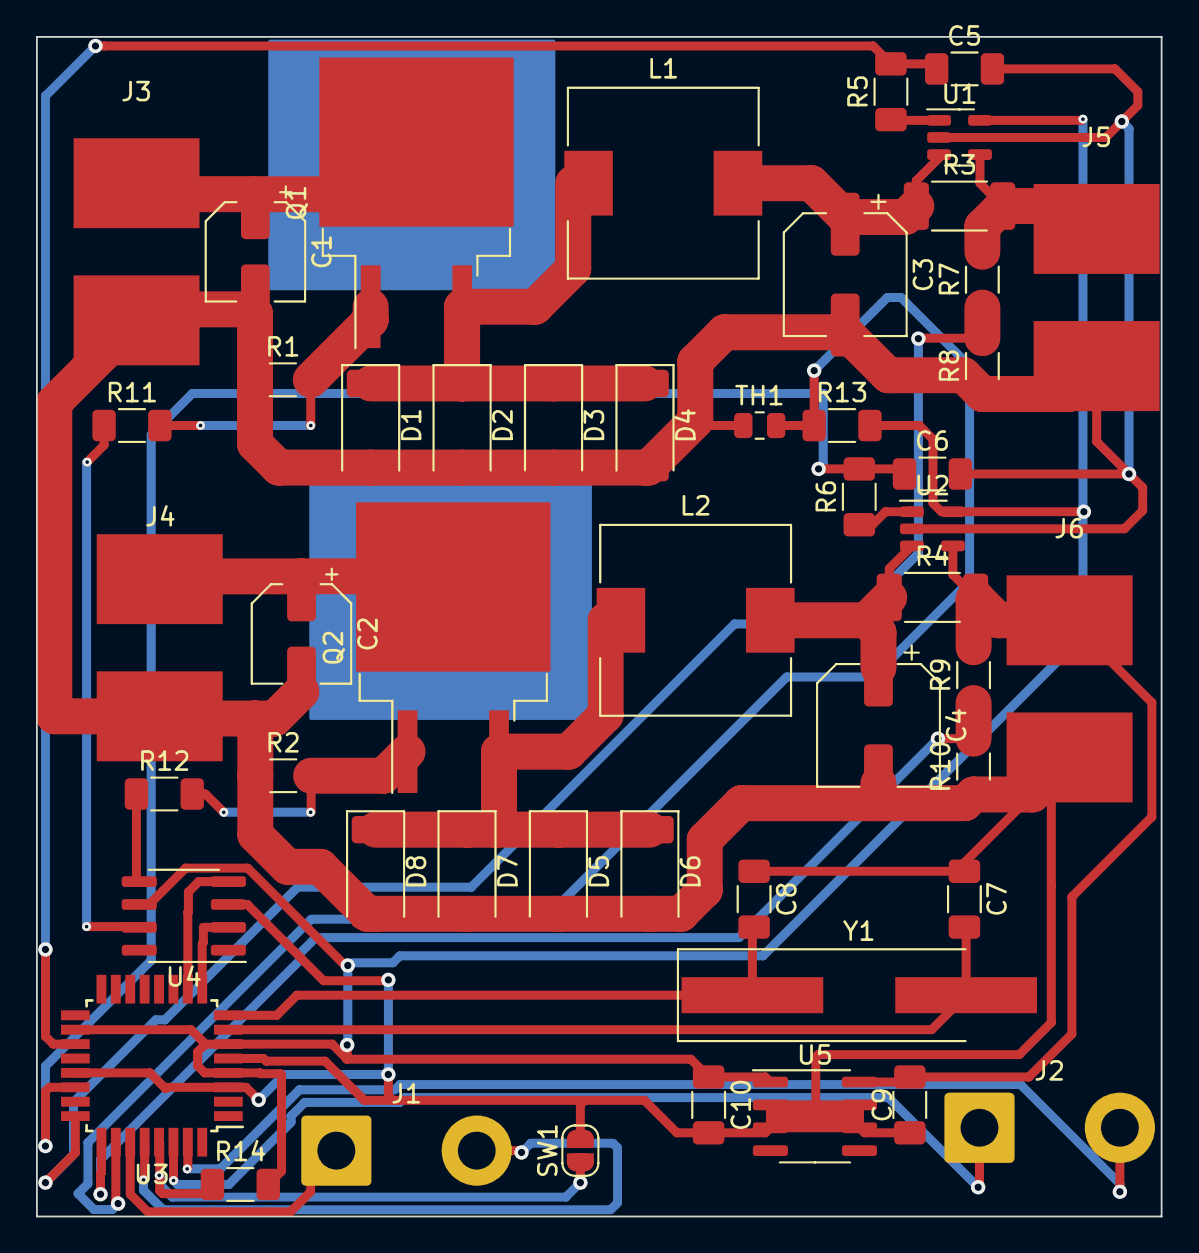
[picture p19: board electronics/mppt_buck/mppt.kicad_pcb from above]

Board: 2 copper layers, 62.5 x 65.5 mm, 50 parts (0 on the bottom side), 29 nets.
