Macikop/Solaris/(commit log)

2022-11-11 first version of mppt
    [mppt.kicad_pcb, mppt.kicad_sch]
2022-11-12 buck mppt added
    [autopilot.kicad_pcb, autopilot.kicad_sch, mppt.kicad_pcb, mppt.kicad_sch]
2022-11-15 added links to resistors
    [mppt.kicad_sch]
2022-11-15 autopilot board almost finished
    [autopilot.kicad_sch, mppt.kicad_pcb]
2022-11-17 autopilot schematic first version
    [autopilot.kicad_pcb, autopilot.kicad_sch]
2022-11-19 autopilot board finished
    [autopilot.kicad_pcb, autopilot.kicad_sch]
2022-11-20 minor fixes
    [airfoil.xlsx, autopilot.kicad_pcb, halo.xlsx, wing.0001.ipt, wing.ipt]
2022-11-20 Added Żebros to model
    [Lotka.ipt, Pianka.ipt, wing.ipt, Żebro Default.ipt, Żebro Montaż.ipt, Żebro z lotką.ipt]
2022-11-21 Added Inventor Assembly file
    [Skrzydło.0004.iam, Skrzydło.iam, Wingspar metrowy.0001.ipt, Wingspar metrowy.ipt, Wingspar pół metra.ipt, Żebro Default.0001.ipt, Żebro Default.ipt, Żebro Default_MIR.ipt]
2022-11-21 autopilot finished secend version
    [autopilot.kicad_pcb, autopilot.kicad_sch]
2022-11-21 mppt cpu reset fix
    [mppt.kicad_pcb, mppt.kicad_sch, power_board.kicad_pcb, power_board.kicad_sch]
2022-11-22 Added pianka to skrzydlo, and cleaned up parts
    [Pianka.ipt, Pianka_2.0001.ipt, Pianka_2.ipt, Skrzydło.0004.iam, Skrzydło.0006.iam, Skrzydło.iam, Żebro Default_MIR.ipt, Żebro Montaż_MIR.ipt]
2022-11-22 power board schematic almost finished
    [autopilot.kicad_pcb, autopilot.kicad_sch, mppt.kicad_pcb, mppt.kicad_sch, power_board.kicad_sch]
2022-11-25 power board pcb not finished
    [power_board.kicad_pcb, power_board.kicad_sch]
2022-11-25 shop links added
    [mppt.kicad_sch]
2022-11-25 links fixed
    [autopilot.kicad_sch, mppt.kicad_sch, power_board.kicad_sch]
2022-11-25 futher fixes
    [power_board.kicad_sch]
2022-11-25 powerboard link fix
    [power_board.kicad_sch]
2022-11-25 links almost fixed finally
    [mppt.kicad_sch]
2022-11-28 mppt part list corrected
    [mppt.kicad_pcb, mppt.kicad_sch]
2022-12-02 power board finished
    [power_board.kicad_pcb, power_board.kicad_sch]
2022-12-03 autopilot board minor fixes
    [autopilot.kicad_pcb]
2022-12-07 wing joint added
    [autopilot.kicad_sch, kuplung.0002.ipt, kuplung.ipt, Żebro Montaż.0009.ipt, Żebro Montaż.0010.ipt, Żebro Montaż.ipt]
2022-12-09 Addec second wing assembly
    [Junk.0001.iam, Junk.iam, Junk_Wingspar.0001.ipt, Junk_Wingspar.ipt, Lotka.0002.ipt, Lotka.ipt, Lotka_MIR.ipt, Skrzydlo sterowe.0002.iam]
2022-12-09 kadlub added
    [kadlub.ipt]
2022-12-09 kadlub nose need fix
    [kadlub.0003.ipt, kadlub.ipt]
2022-12-09 Changed Kadlub nose to be more boar-like
    [Skrzydło.0007.iam, Skrzydło.0008.iam, Skrzydło.iam, Wingspar metrowy.0001.ipt, Wingspar metrowy.0002.ipt, Wingspar metrowy.ipt, kadlub.0003.ipt, kadlub.0004.ipt]
2022-12-12 secend version of kadlub
    [kadlub v2.ipt]
2022-12-16 added mewa.iam and added dimensions to zebro_kadlub.ipt
    [Kadłub v3.0004.ipt, Kadłub v3.ipt, Skrzydło.0008.iam, Skrzydło.0009.iam, Skrzydło.iam, mewa.iam, Żebro_Kadłub.0003.ipt, Żebro_Kadłub.0006.ipt]
2022-12-27 new model
    [Lotka.ipt, autopilot.kicad_pcb, autopilot.kicad_sch, kadlub v2.0002.ipt, kadlub v2.ipt, kadłub.0002.ipt, kadłub.ipt, wingspar.ipt]
2022-12-29 tail ribs
    [Tlotka.ipt, Tżebro default.ipt, Tżebro sketch.0001.ipt, Tżebro sketch.ipt, Tżebro z lotkąt.ipt, kadłub.0002.ipt, kadłub.0004.ipt, kadłub.ipt]
2023-01-04 new kuplung and other
    [Assembly1.iam, Lotka.0001.ipt, Lotka.ipt, Part1.ipt, Part10.ipt, Part11.ipt, Part12.ipt, Part13.ipt]
2023-01-05 added samolot assembly
    [Assembly1.iam, Lotka.0001.ipt, Lotka.0003.ipt, Lotka.ipt, Part17.0001.ipt, Part17.ipt, Part19.0001.ipt, Part19.ipt]
2023-01-05 fixed samolot
    [Samolot.0003.iam, Samolot.0004.iam, Samolot.iam, Skrzydło.0014.iam, Skrzydło.0016.iam, Skrzydło.iam, skrzydlo_ster.0004.iam, skrzydlo_ster.0005.iam]
2023-01-15 new kadłub
    [battery.ipt, motor.ipt, nowy kadłub.0004.ipt, nowy kadłub.ipt]
2023-01-16 Fixed main assembly
    [Lotka.0003.ipt, Lotka.0004.ipt, Lotka.ipt, Lotka_MIR.ipt, Samolot.0004.iam, Samolot.0006.iam, Samolot.iam, Skrzydło.0016.iam]
2023-02-05 added wingspar brackets
    [nowy kadłub.0007.ipt, nowy kadłub.0010.ipt, nowy kadłub.ipt]
2023-02-07 3d renders of electronics
    [autopilot.kicad_pcb, mppt.kicad_pcb, mppt.kicad_sch, power_board.kicad_pcb]
2023-02-08 fixed tail angle, set appearance on all parts
    [Samolot.0006.iam, Samolot.0009.iam, Samolot.iam, Tail.0003.iam, Tail.0004.iam, Tail.iam, Tmouint-edito.0004.ipt, Tmouint-edito.ipt]
2023-02-10 added poszycie, silnik, panele and added colours to model
    [APC_9x6.SLDPRT, APC_9x6.ipt, Panele.0004.ipt, Panele.ipt, Poszycie skrzydlo glowne.ipt, Poszycie skrzydlo sterowe.0002.ipt, Poszycie skrzydlo sterowe.ipt, Poszycie.0004.ipt]
2023-02-10 added samolot bez sparow
    [Samolot bez sparow.iam]
2023-02-14 added stls
    [Powietrze.0001.ipt, Powietrze.ipt, Samolot w wodzie.iam]
2023-02-21 renders, pdf and merge
    [mew.iam]
2023-02-21 autopilot schematic fixed
2023-03-20 added connector to nowy kadlub
    [Poszycie.0004.ipt, Poszycie.0005.ipt, Poszycie.ipt, Samolot.0021.iam, Samolot.0023.iam, Samolot.iam, nowy kadłub.0015.ipt, nowy kadłub.0016.ipt]
2023-03-21 minor changes
    [Junk.0001.iam, Junk.iam, Junk_Wingspar.0001.ipt, Junk_Wingspar.ipt, Kadłub v3.0004.ipt, Kadłub v3.ipt, Lotka.0002.ipt, Lotka.ipt]
2023-03-21 cleaned things up
    [Powietrze.ipt, Samolot w wodzie.iam, cienki_spar_krotki.ipt, small carbon tube.ipt, Żero montaż.ipt]
2023-03-21 cleaned thing up
    [Part1.ipt, Part10.ipt, Part11.ipt, Part12.ipt, Part13.ipt, Part14.ipt, Part15.ipt, Part16.ipt]
2023-04-06 added milling jigsaw
    [Frezowanie No.1.0005.iam, Frezowanie No.1.iam, Frezowanie No.2.0003.iam, Frezowanie No.2.iam, Frezowanie_male No.1.0002.iam, Frezowanie_male No.1.iam, Frezowanie_male No.2.0001.iam, Frezowanie_male No.2.iam]
2023-04-15 fixed kadlub.ipt
    [Frezowanie No.1.0005.iam, Frezowanie No.1.0006.iam, Frezowanie No.1.iam, Frezowanie No.2.0003.iam, Frezowanie No.2.0004.iam, Frezowanie No.2.iam, Frezowanie_male No.2.0001.iam, Frezowanie_male No.2.0002.iam]
2023-04-19 electronics remake
    [Frezowanie No.1.0006.iam, Frezowanie No.1.0007.iam, Frezowanie No.1.iam, Frezowanie No.2.0004.iam, Frezowanie No.2.0005.iam, Frezowanie No.2.iam, Frezowanie_male No.1.0002.iam, Frezowanie_male No.1.0004.iam]
2023-04-19 autopilot rework
    [autopilot.kicad_pcb, autopilot.kicad_sch]
2023-04-30 added frez_zebra
    [Balsa(95x1000x1.5).0003.ipt, Balsa(95x1000x3).ipt, Frez No,1.0003.iam, Frez No,1.iam, Frez No,2.0001.iam, Frez No,2.iam, Frez No,3.iam]
2023-05-07 added jig
    [Front_aligner.0002.ipt, Front_aligner.ipt, Jig_1.0005.ipt, Jig_1.ipt, Jig_assembly.0002.iam, Jig_assembly.iam]
2023-05-08 updated jig
    [Jig_1.0005.ipt, Jig_1.0006.ipt, Jig_1.ipt, Jig_assembly.0002.iam, Jig_assembly.0004.iam, Jig_assembly.iam, Slider.ipt, Widełki.ipt]
2023-05-09 added back jig
    [Back_back_aligner.ipt, Back_front_aligner.0001.ipt, Back_front_aligner.ipt, Front_aligner.0002.ipt, Front_aligner.0003.ipt, Front_aligner.ipt, Jig_1.0006.ipt, Jig_1.0010.ipt]
2023-05-20 added servo slot in tail
    [Jig_assembly.0011.iam, Jig_assembly.0012.iam, Jig_assembly.iam, Samolot.0025.iam, Samolot.0027.iam, Samolot.iam, Tail Poszycie.0001.ipt, Tail Poszycie.0002.ipt]
2023-05-21 added presentation
    [Poszycie skrzydlo glowne.0001.ipt, Poszycie skrzydlo glowne.ipt, Poszycie skrzydlo sterowe.0002.ipt, Poszycie skrzydlo sterowe.0003.ipt, Poszycie skrzydlo sterowe.ipt, Samolot.0001.ipn, Samolot.0027.iam, Samolot.0029.iam]
2023-06-08 added servo slots to kupplung
    [Samolot.0029.iam, Samolot.0031.iam, Samolot.iam, kuplung.0004.ipt, kuplung.0005.ipt, kuplung.ipt]
2023-08-17 autopilot buffer footprint fixed
    [Samolot.0031.iam, Samolot.0033.iam, Samolot.iam, Skrzydło.0019.iam, Skrzydło.0022.iam, Skrzydło.iam, Tail.0007.iam, Tail.0009.iam]
2023-09-12 small fixes
    [Samolot.0033.iam, Samolot.0034.iam, Samolot.iam, Skrzydło.0022.iam, Skrzydło.0023.iam, Skrzydło.iam, Tail.0009.iam, Tail.0010.iam]
2023-10-06 new mppt design
    [ESC.ipt, Radio.0003.ipt, Radio.ipt, Samolot.0034.iam, Samolot.0037.iam, Samolot.iam, autopilot.kicad_pcb, autopilot.kicad_sch]
